YasiruAlahakoon/Battery-Profiler/README.md

# batteryprofiler
This is a repository containing all necessary documents of the battery profiler we designed
