YasiruAlahakoon/Battery-Profiler/All_ Desighn Documentationsd - Completed/Battery Profiler Photos.pdf

## EN2160 Electronic Design Realization

## Proof of work


Index Numbers: | 210027C, 210236P, 210253N, 210272V
Group: | Battery Profiler
Module: | EN2160
Date of Submission: | 2024.06.29

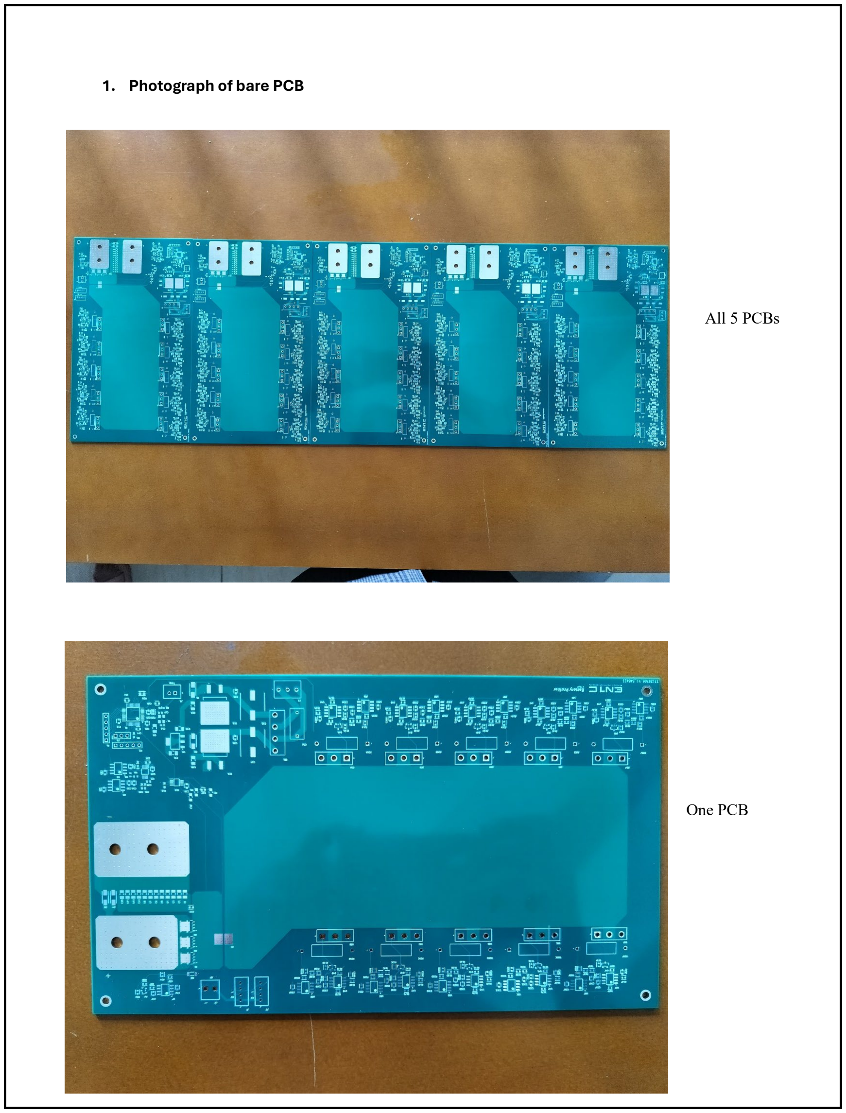
[picture p40: page 2]

### 1. Photograph of bare PCB

All 5 PCBs

One PCB

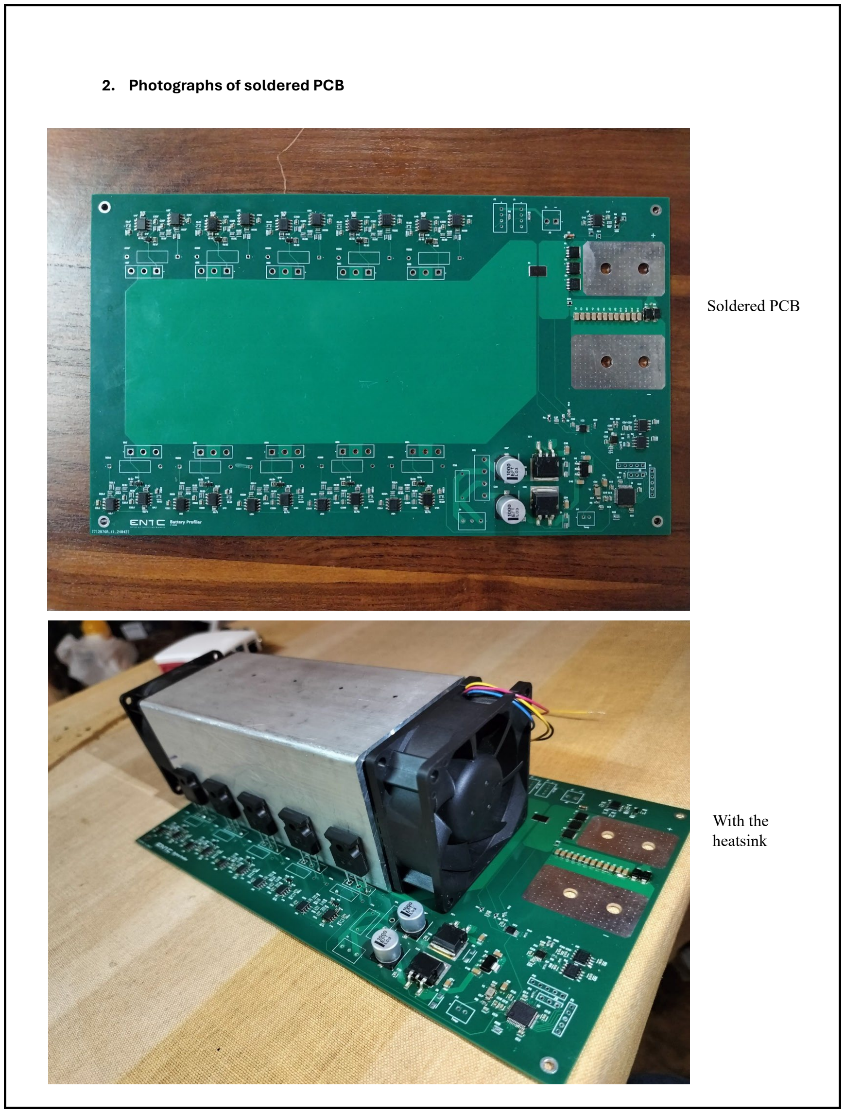
[picture p41: page 3]

### 2. Photographs of soldered PCB

Soldered PCB

With the
heatsink

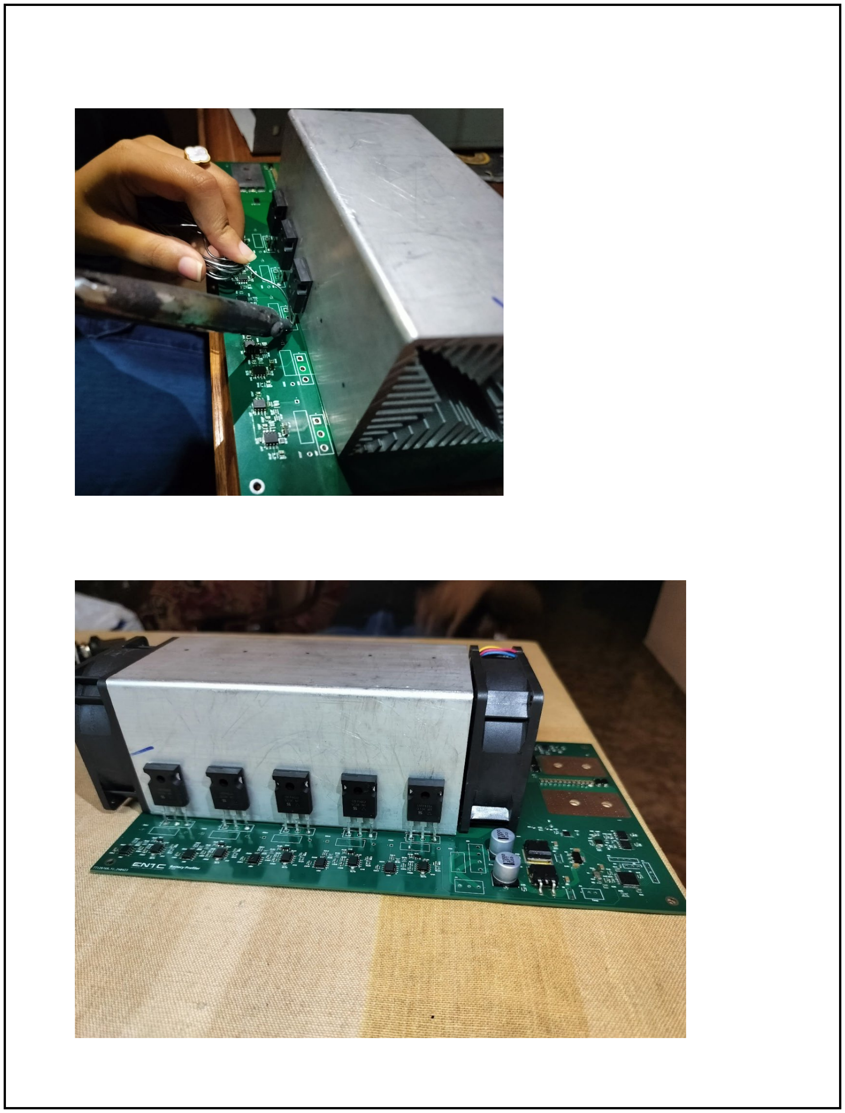
[picture p42: page 4]

3.Testing

Note: Due to labs being closed, we were unable to perform all tests fully. In these photos, we only checked for continuity and shorts.

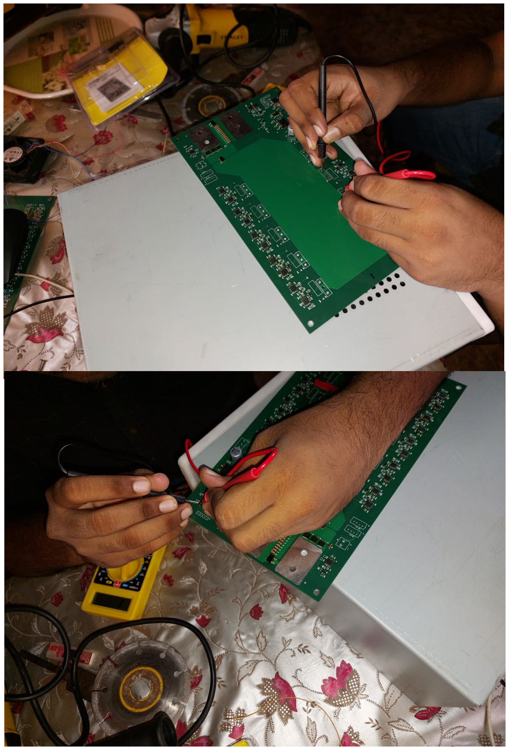
[picture p43: figure]

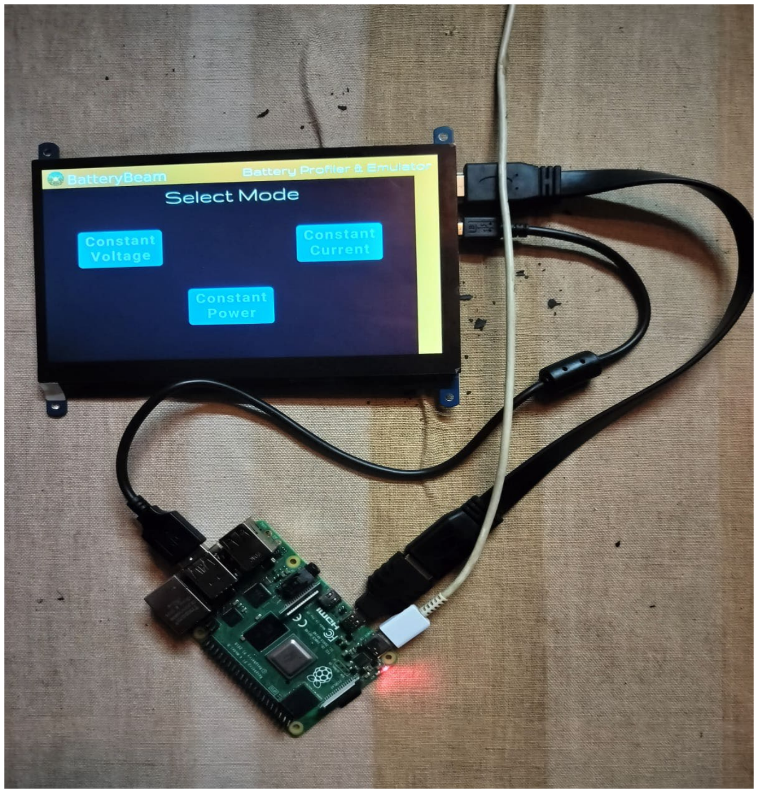
[picture p44: figure]

UI testing

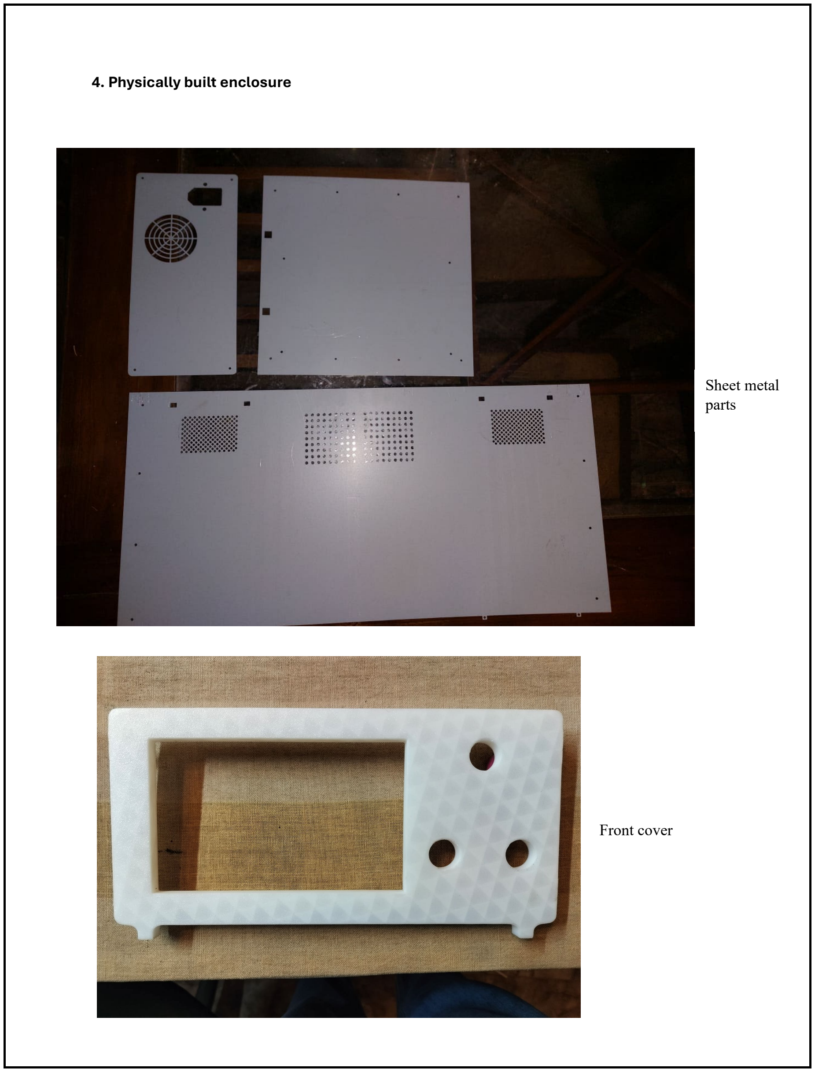
[picture p45: page 7]

### 4. Physically built enclosure

Sheet metal
parts

Front cover

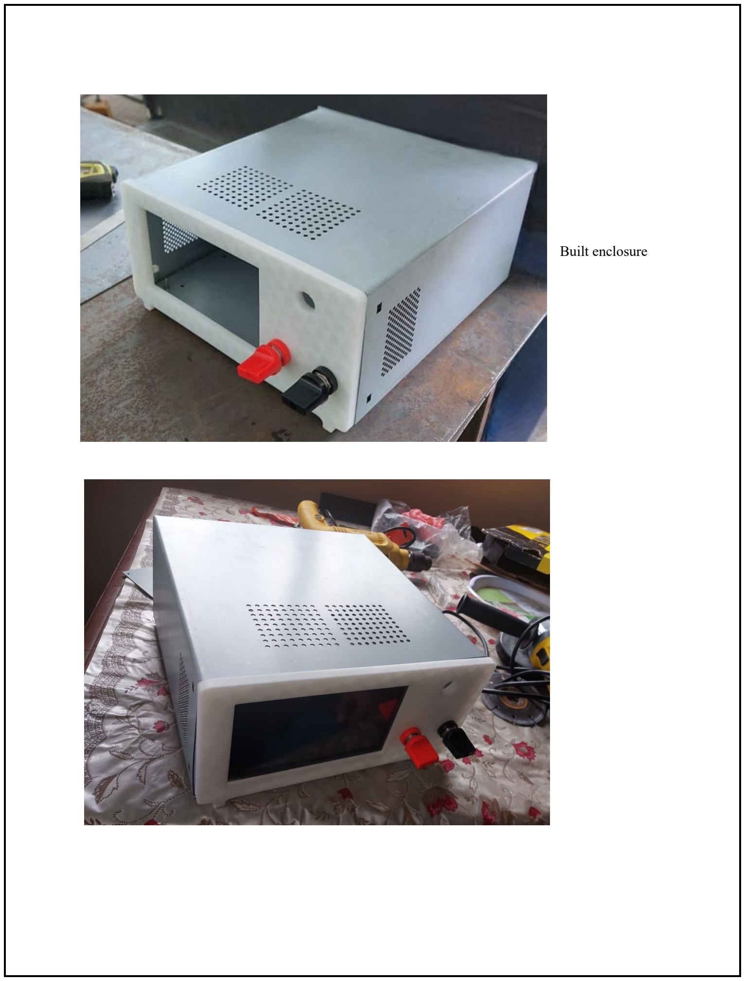
[picture p46: page 8]

Built enclosure

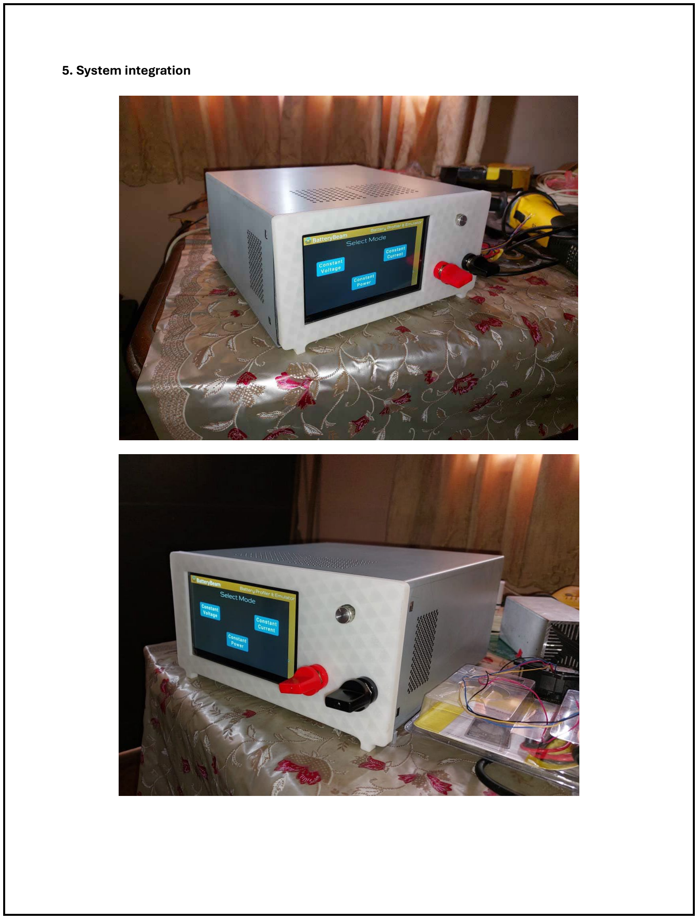
[picture p47: page 9]

### 5. System integration
