YasiruAlahakoon/Battery-Profiler/Enclosure - FULL PROJECT/PCB Mount Assembly.SLDASM

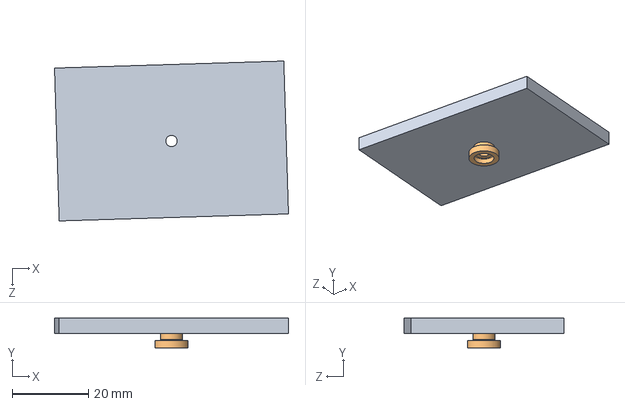
[picture p48: CAD file, 2024-08-21]
Enclosure - FULL PROJECT/PCB Mount Assembly.SLDASM
61.2 x 7.80 x 41.8 mm
PCB Mount
PCB Top mount
