YasiruAlahakoon/Battery-Profiler/Enclosure - FULL PROJECT/Main Sheet metal part.SLDPRT

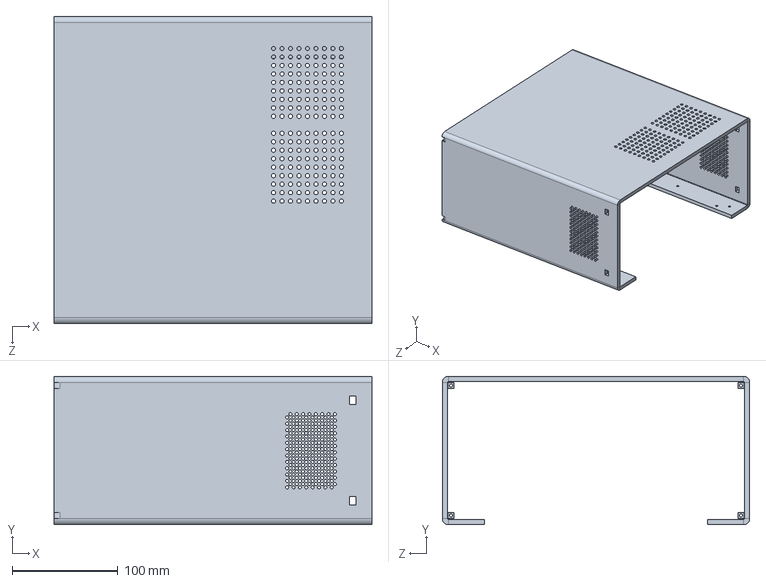
[picture p49: CAD file, 2024-08-21]
Enclosure - FULL PROJECT/Main Sheet metal part.SLDPRT
300.0 x 140.0 x 290.0 mm
