YasiruAlahakoon/Battery-Profiler/Enclosure - FULL PROJECT/Main Sheet metal part flat.STEP

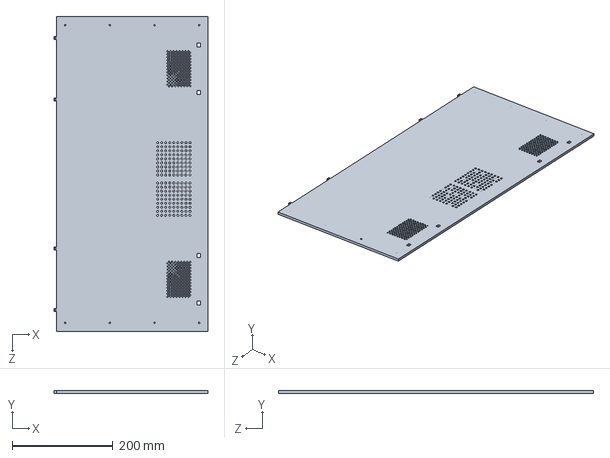
[picture p50: CAD file, 2024-08-21]
Enclosure - FULL PROJECT/Main Sheet metal part flat.STEP
304.6 x 5.00 x 624.4 mm
