YasiruAlahakoon/Battery-Profiler/enclosure/Back Plate.SLDPRT

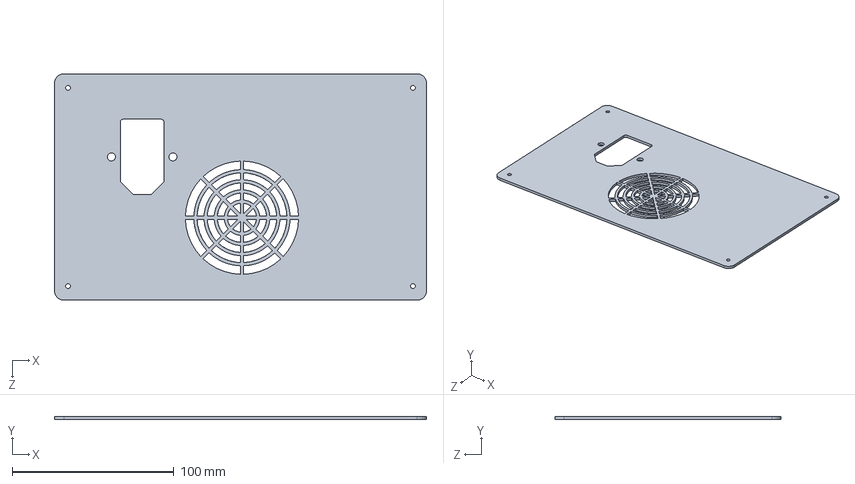
[picture p51: CAD file, 2024-07-14]
enclosure/Back Plate.SLDPRT
230.0 x 2.00 x 140.0 mm
