YasiruAlahakoon/Battery-Profiler/Enclosure - FULL PROJECT/PCB Mount.SLDPRT

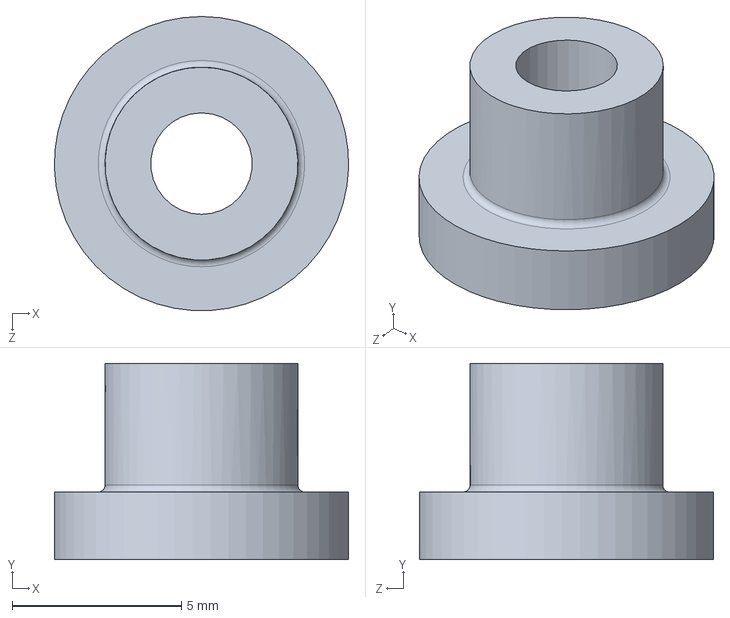
[picture p52: CAD file, 2024-08-21]
Enclosure - FULL PROJECT/PCB Mount.SLDPRT
8.70 x 5.80 x 8.69 mm
