YasiruAlahakoon/Battery-Profiler/Enclosure - FULL PROJECT/Rectangle Button.SLDPRT

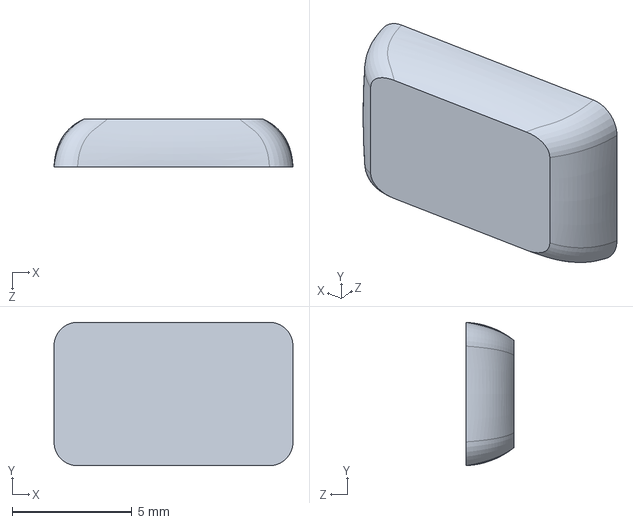
[picture p53: CAD file, 2024-08-21]
Enclosure - FULL PROJECT/Rectangle Button.SLDPRT
10.0 x 6.00 x 2.00 mm
