YasiruAlahakoon/Battery-Profiler/Enclosure - FULL PROJECT/Back Plate.SLDPRT

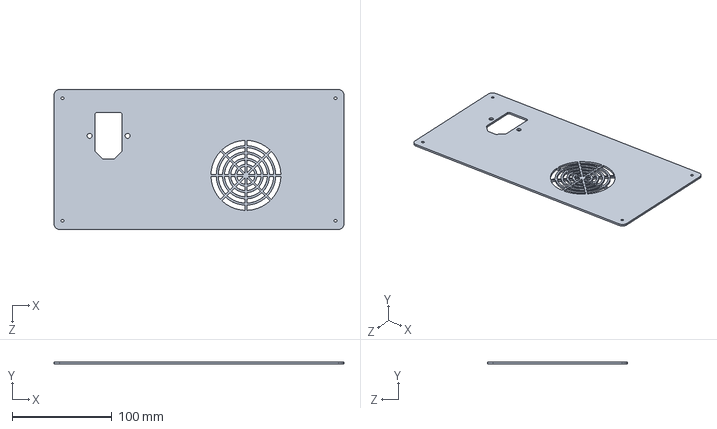
[picture p54: CAD file, 2024-08-21]
Enclosure - FULL PROJECT/Back Plate.SLDPRT
290.0 x 2.00 x 140.0 mm
