YasiruAlahakoon/Battery-Profiler/Enclosure - FULL PROJECT/Front Cover.SLDPRT

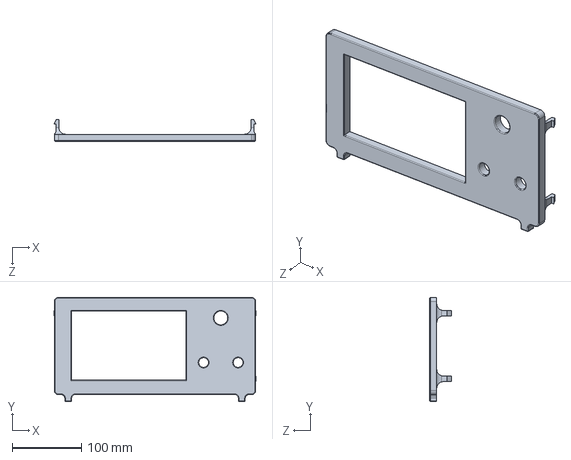
[picture p55: CAD file, 2024-08-21]
Enclosure - FULL PROJECT/Front Cover.SLDPRT
291.0 x 150.0 x 31.0 mm
