YasiruAlahakoon/Battery-Profiler/Enclosure - FULL PROJECT/Circular Button.SLDPRT

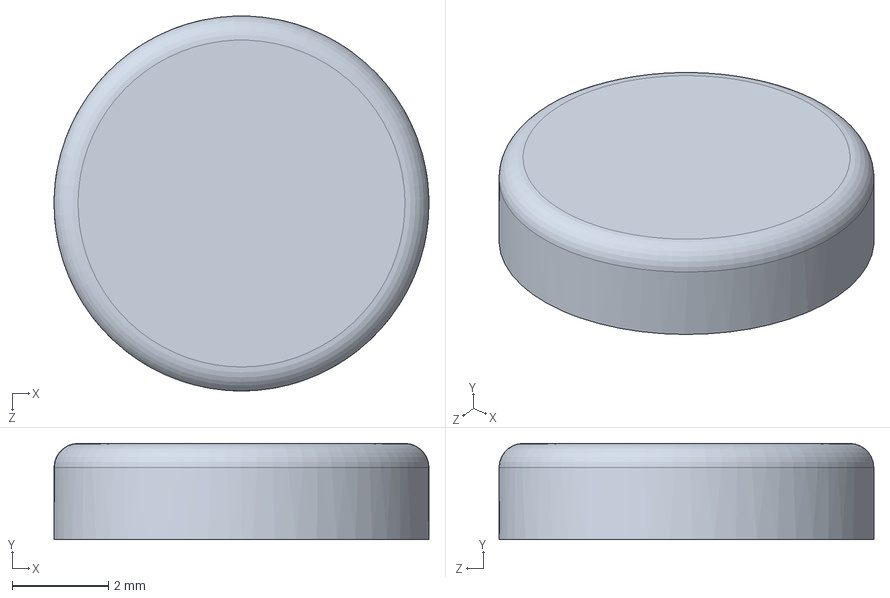
[picture p56: CAD file, 2024-08-21]
Enclosure - FULL PROJECT/Circular Button.SLDPRT
7.80 x 2.00 x 7.80 mm
