YasiruAlahakoon/Battery-Profiler/Enclosure - FULL PROJECT/Bottom Plate.SLDPRT

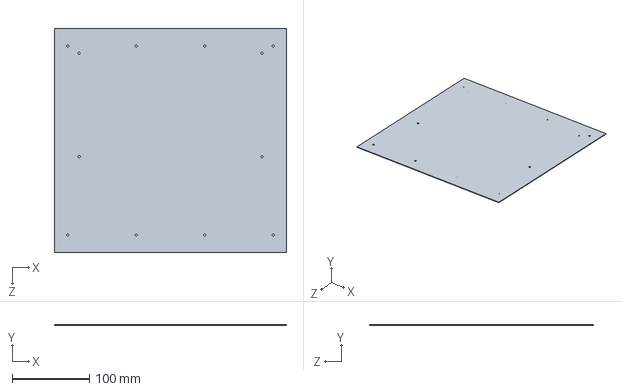
[picture p57: CAD file, 2024-08-21]
Enclosure - FULL PROJECT/Bottom Plate.SLDPRT
300.0 x 1.00 x 290.0 mm
