YasiruAlahakoon/Battery-Profiler/Enclosure - FULL PROJECT/BNC.STEP

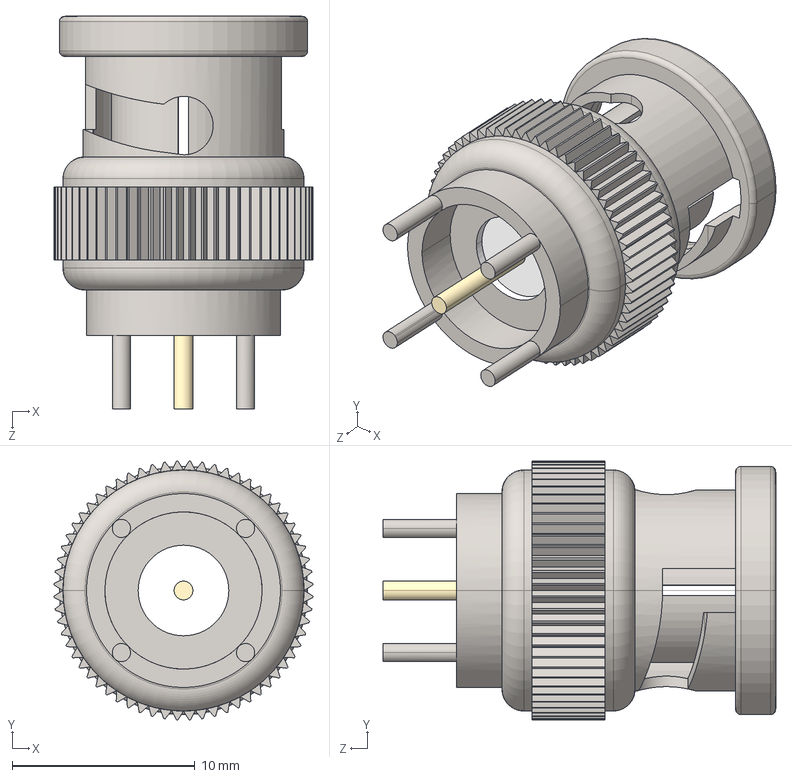
[picture p58: CAD file, 2024-08-21]
Enclosure - FULL PROJECT/BNC.STEP
14.2 x 14.2 x 21.5 mm
