YasiruAlahakoon/Battery-Profiler/Enclosure - FULL PROJECT/Rotary Encoder.SLDPRT

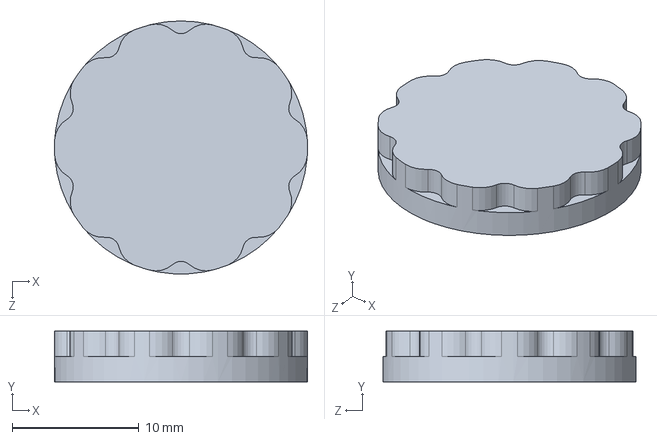
[picture p59: CAD file, 2024-08-21]
Enclosure - FULL PROJECT/Rotary Encoder.SLDPRT
20.0 x 4.00 x 20.0 mm
