YasiruAlahakoon/Battery-Profiler/Enclosure - FULL PROJECT/IEC Connector with Power Switch.SLDPRT

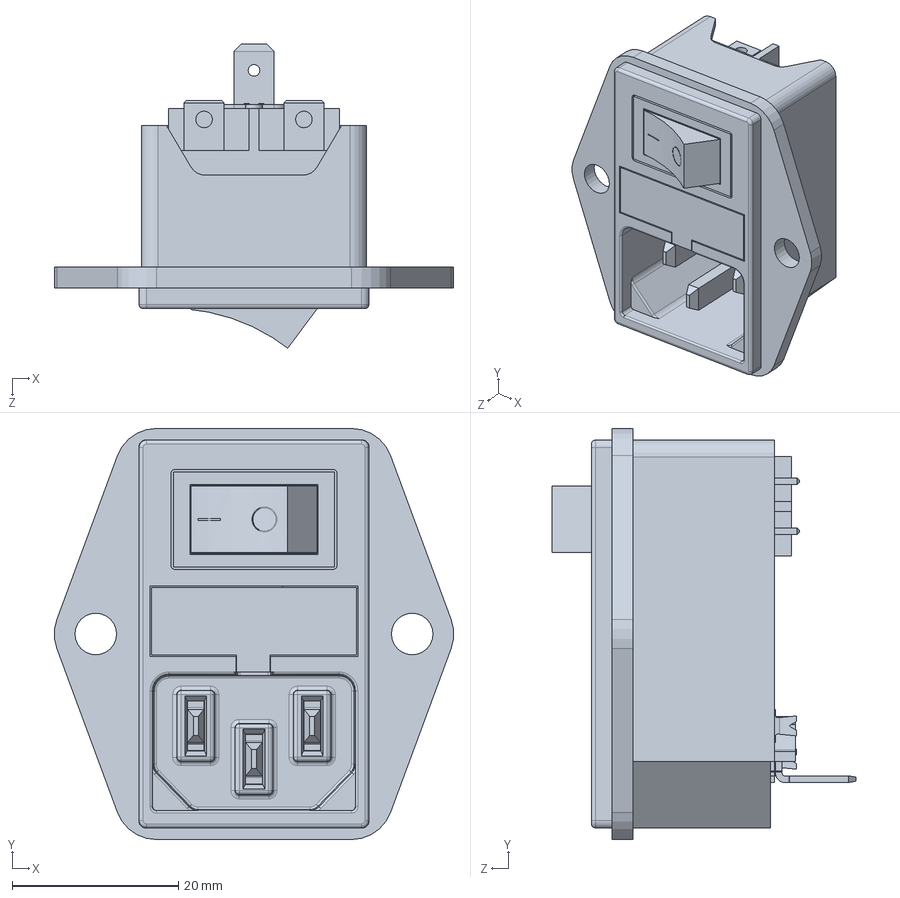
[picture p60: CAD file, 2024-08-21]
Enclosure - FULL PROJECT/IEC Connector with Power Switch.SLDPRT
48.0 x 49.4 x 36.6 mm
