YasiruAlahakoon/Battery-Profiler/Enclosure - FULL PROJECT/Heat Sink.STEP

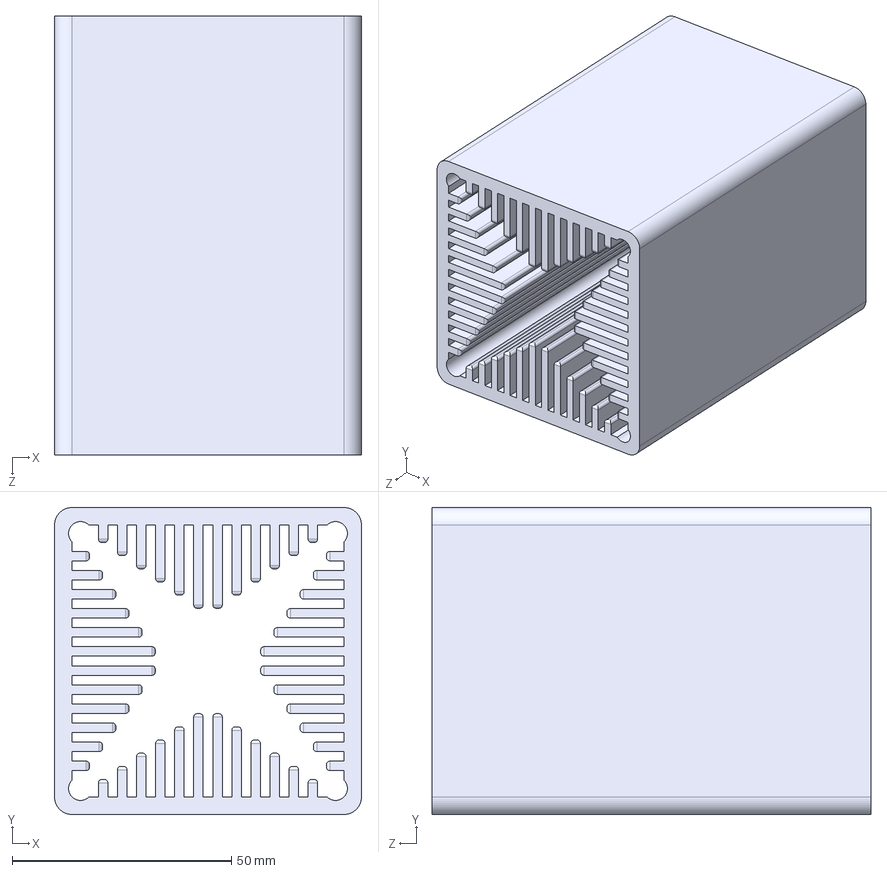
[picture p61: CAD file, 2024-08-21]
Enclosure - FULL PROJECT/Heat Sink.STEP
70.0 x 70.0 x 100.0 mm
