YasiruAlahakoon/Battery-Profiler/Enclosure - FULL PROJECT/PCB Top mount.SLDPRT

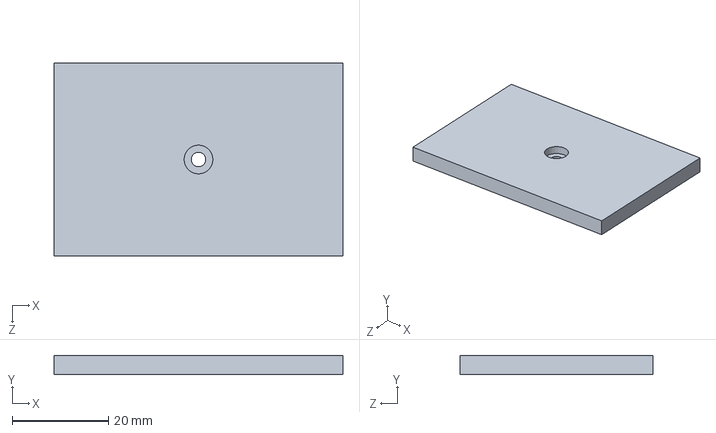
[picture p62: CAD file, 2024-08-21]
Enclosure - FULL PROJECT/PCB Top mount.SLDPRT
60.0 x 4.00 x 40.0 mm
