YasiruAlahakoon/Battery-Profiler/Enclosure - FULL PROJECT/waveshare 7inch HDMI LCD 1024x600.stp

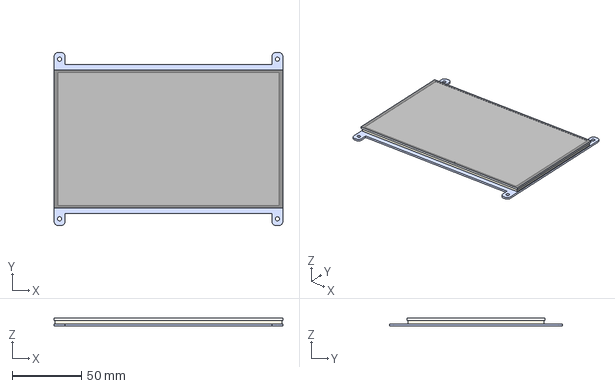
[picture p63: CAD file, 2024-08-21]
Enclosure - FULL PROJECT/waveshare 7inch HDMI LCD 1024x600.stp
164.9 x 124.7 x 5.68 mm
