YasiruAlahakoon/Battery-Profiler/Enclosure - FULL PROJECT/Heat sink assmebly.SLDASM

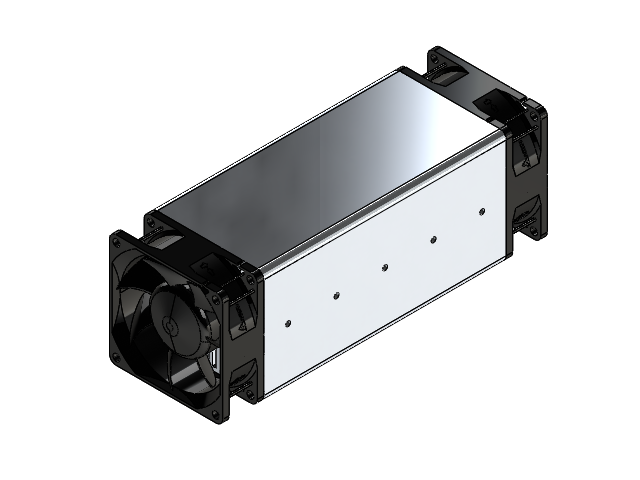
[picture p64: CAD file, 2024-08-21]
Enclosure - FULL PROJECT/Heat sink assmebly.SLDASM
Heat Sink
PRT0001.stp x 2
IMP.stp x 2
