YasiruAlahakoon/Battery-Profiler/Enclosure - FULL PROJECT/AFB0712SHX02.SLDASM

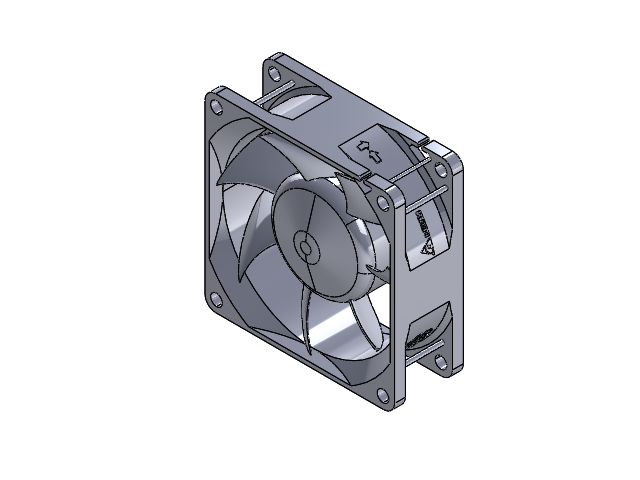
[picture p65: CAD file, 2024-07-14]
Enclosure - FULL PROJECT/AFB0712SHX02.SLDASM
PRT0001.stp
IMP.stp
