YasiruAlahakoon/Battery-Profiler/(list of files, cad)

Other CAD files:
Enclosure - FULL PROJECT/Battery Profiler.STEP
Enclosure - FULL PROJECT/PCB1.step
Enclosure - FULL PROJECT/Battery Profiler.SLDASM
Enclosure - FULL PROJECT/Heat Sink.SLDPRT
