YasiruAlahakoon/Battery-Profiler/(list of files, drawings)

Other design files:
EDR_MUL_test01.ms14
PCB doc/Analog.SchDoc
PCB doc/Battery Profiler.PrjPcb
PCB doc/DAC.SchDoc
PCB doc/FanControl.SchDoc
PCB doc/Main.SchDoc
PCB doc/MCU.SchDoc
PCB doc/PCB1.PcbDoc
PCB doc/Power.SchDoc
PCB doc/Sense Amplifier.SchDoc
Simulation - FULL PROJECT/feedback1.ms14
Simulation - FULL PROJECT/feedback parallel10.ms14
